charlysan/pico-ttl2dvi/docs/waveshare/idc_pinout.txt

DB-9 (male, front view)        IDC-10 (front view)

   1   2   3   4   5             1   3   5   7   9
 \ o   o   o   o   o /         [ o   o   o   o   o ]
   \ o   o   o   o /           [ o   o   o   o   o ]
     6   7   8   9               2   4   6   8   10

 DB-9        IDC-10
-------------------
 pin 1  <->  pin 1
 pin 2  <->  pin 2
 pin 3  <->  pin 3
 pin 4  <->  pin 4
 pin 5  <->  pin 5
 pin 6  <->  pin 6
 pin 7  <->  pin 7
 pin 8  <->  pin 8
 pin 9  <->  pin 9
 NC     <->  pin 10

 NC = Not Connected
