charlysan/pico-ttl2dvi/docs/waveshare/rp2350_pizero_waveshare_pinout.txt

              J5
 Function  Label    Pin | Pin  Label    Function
-------------------------+-------------------------
           3V3       1  |  2   VBUS
 SDA       GPIO2     3  |  4   VBUS
 SCL       GPIO3     5  |  6   GND
           GPIO14    7  |  8   GPIO4    TX
           GND       9  | 10   GPIO5    RX
           GPIO17   11  | 12   GPIO18
           GPIO27   13  | 14   GND
           GPIO22   15  | 16   GPIO23
           3V3      17  | 18   GPIO24
 SPI_MOSI  GPIO11   19  | 20   GND
 SPI_MISO  GPIO12   21  | 22   GPIO25
 SPI_SCLK  GPIO10   23  | 24   GPIO8    CE0
           GND      25  | 26   GPIO7    CE1
 ID_SDA    GPIO0    27  | 28   GPIO1    ID_SCL
           GPIO15   29  | 30   GND
           GPIO6    31  | 32   GPIO9
           GPIO13   33  | 34   GND
           GPIO19   35  | 36   GPIO16
           GPIO26   37  | 38   GPIO20
           GND      39  | 40   GPIO21
