charlysan/pico-ttl2dvi/hardware/tht/revA/ttl2dvi_tht.kicad_sch

## KiCad design hardware/tht/revA/ttl2dvi_tht.kicad_sch (2026-10-14)

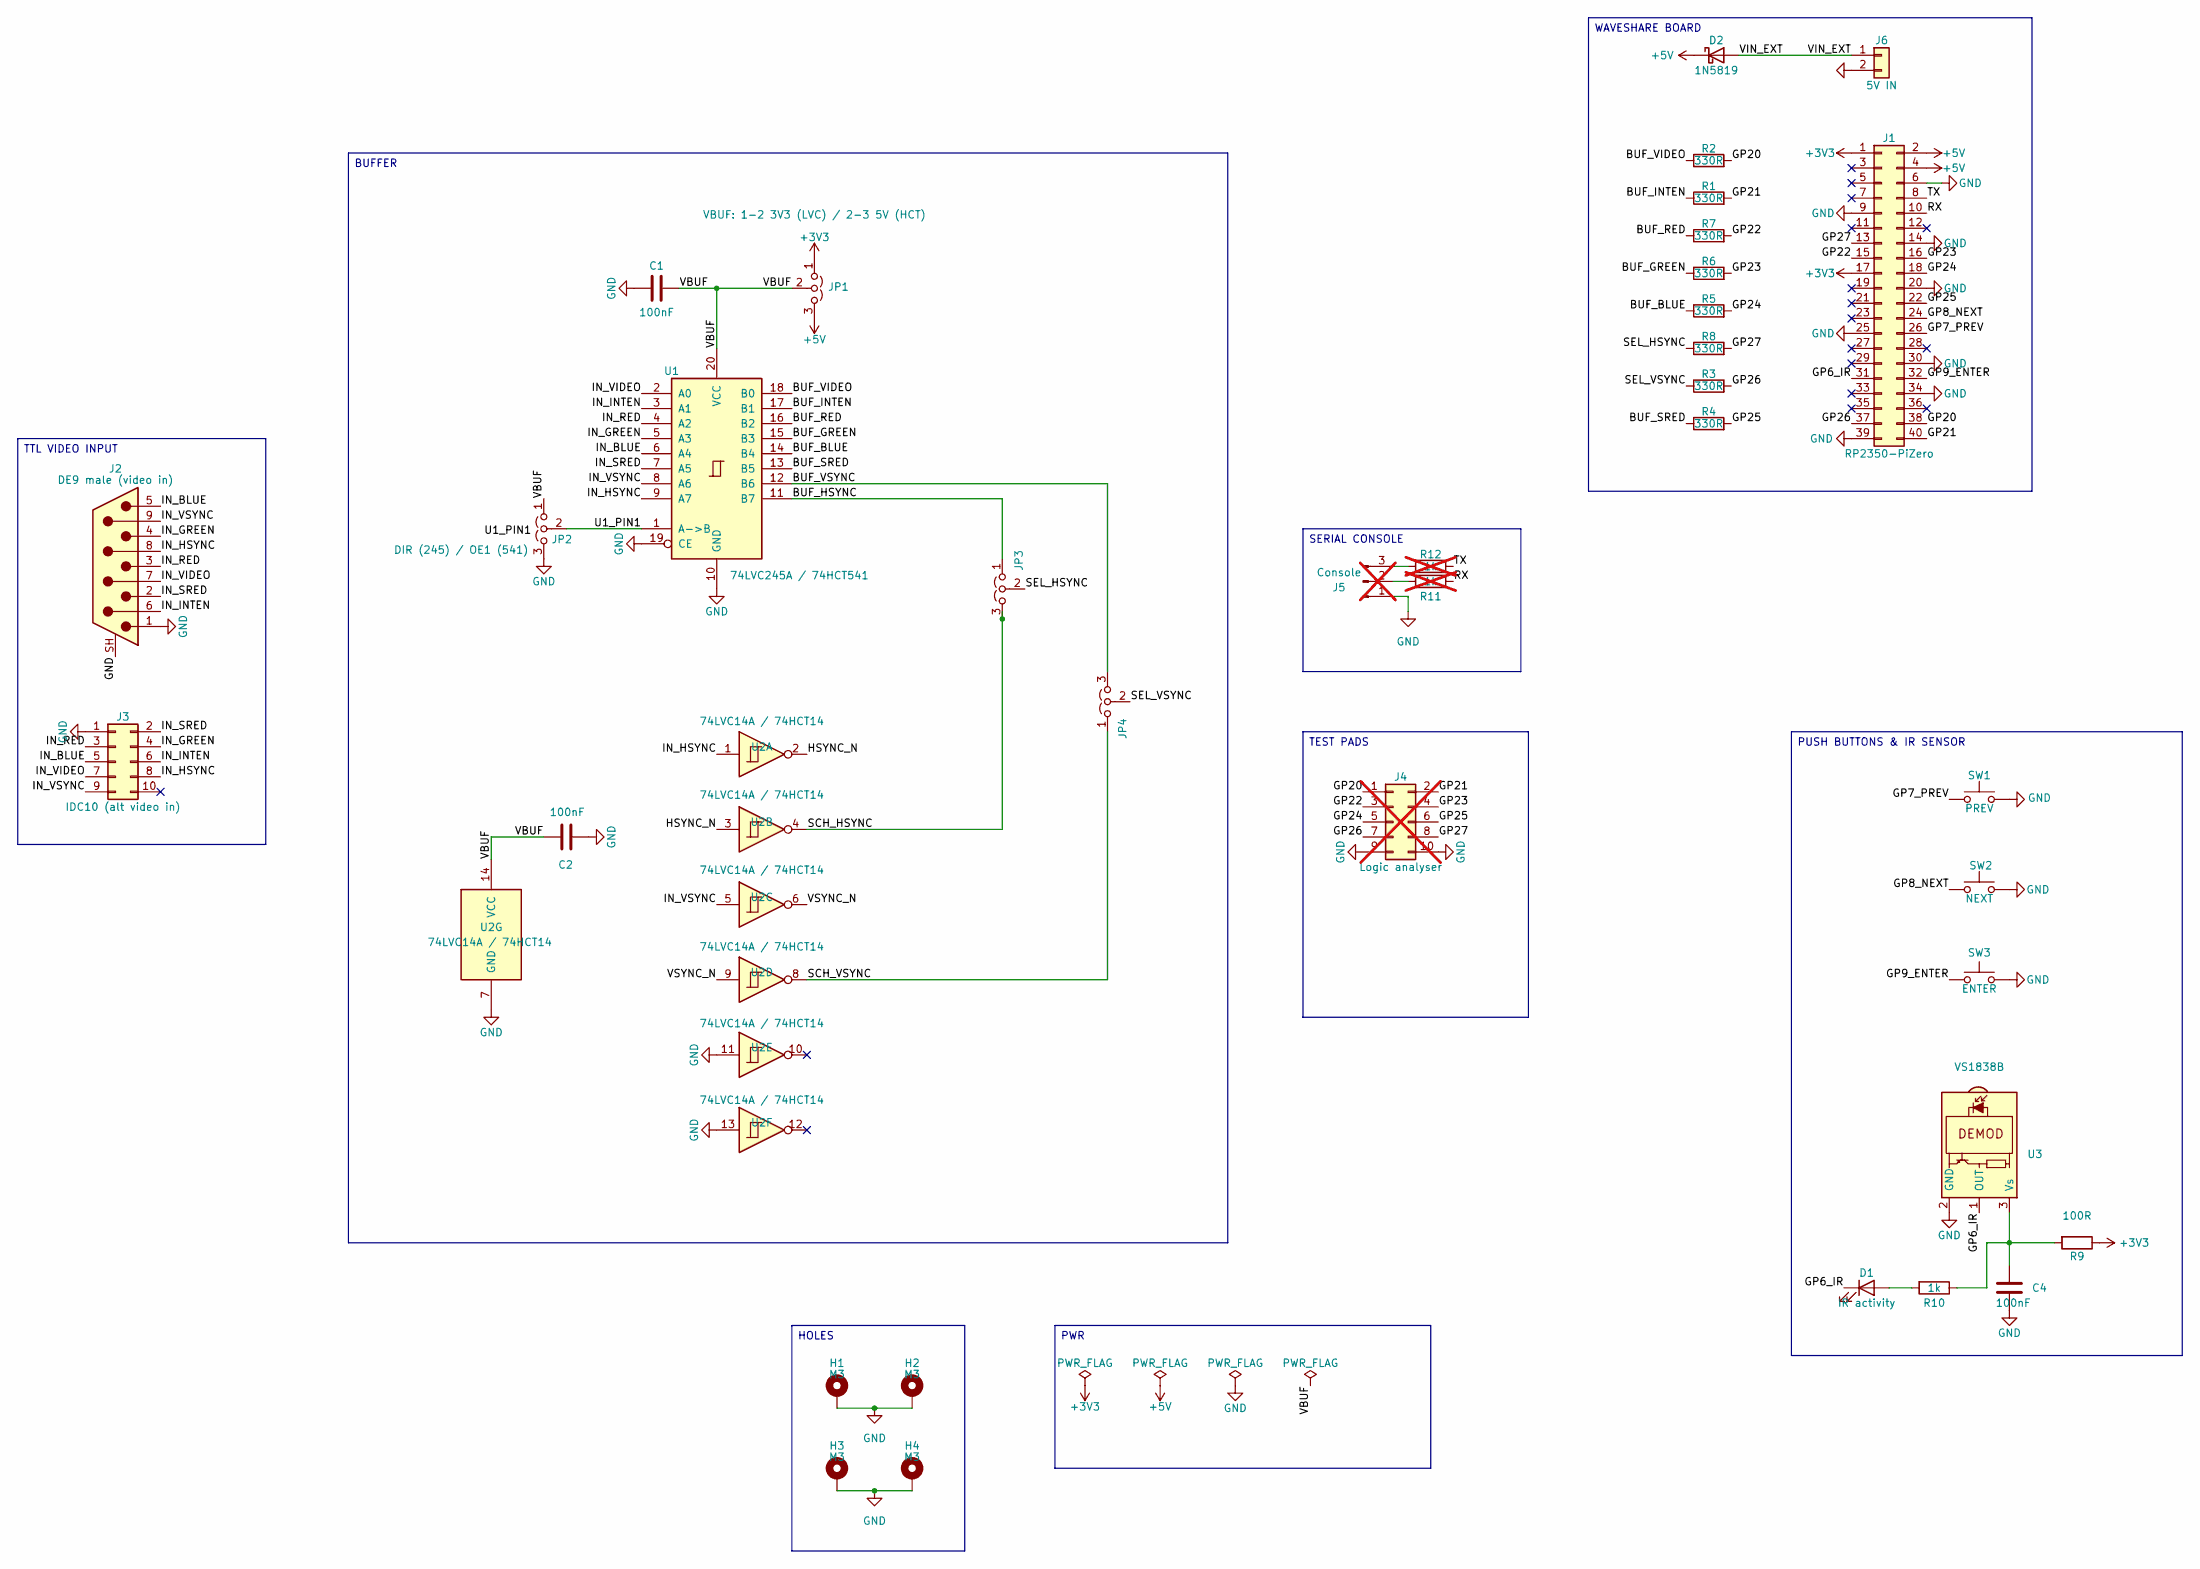
[picture p4: schematic ttl2dvi_tht.kicad_sch]

Parts:
C1, C2, C4: 100nF; C_Disc_D5.0mm_W2.5mm_P5.00mm
D1: IR activity; LED_D3.0mm
D2: 1N5819; D_DO-41_SOD81_P10.16mm_Horizontal
H1, H2, H3, H4: M3; MountingHole_3.2mm_M3_Pad_Via
J1: RP2350-PiZero; Raspberry_Pi_Zero_Socketed_THT_FaceDown_MountingHoles
J2: DE9 male (video in); DSUB-9_Pins_Horizontal_P2.77x2.84mm_EdgePinOffset7.70mm_Hou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
J3: IDC10 (alt video in); IDC-Header_2x05_P2.54mm_Vertical
J4: Logic analyser; PinHeader_2x05_P2.54mm_Vertical; not fitted
J5: Console; PinHeader_1x03_P2.54mm_Vertical; not fitted
J6: 5V IN; JST_XH_B2B-XH-A_1x02_P2.50mm_Vertical
JP1: VBUF: 1-2 3V3 (LVC) / 2-3 5V (HCT); PinHeader_1x03_P2.54mm_Vertical
JP2: DIR (245) / OE1 (541); PinHeader_1x03_P2.54mm_Vertical
JP3: HSYNC: 1-2 BUF / 2-3 SCH; PinHeader_1x03_P2.54mm_Vertical
JP4: VSYNC: 1-2 BUF / 2-3 SCH; PinHeader_1x03_P2.54mm_Vertical
R1, R2, R3, R4, R5, R6, R7, R8: 330R; R_Axial_DIN0207_L6.3mm_D2.5mm_P7.62mm_Horizontal
R9: 100R; R_Axial_DIN0207_L6.3mm_D2.5mm_P7.62mm_Horizontal
R10: 1k; R_Axial_DIN0207_L6.3mm_D2.5mm_P7.62mm_Horizontal
R11, R12: 1k; R_Axial_DIN0207_L6.3mm_D2.5mm_P7.62mm_Horizontal; not fitted
SW1: PREV; SW_PUSH_6mm
SW2: NEXT; SW_PUSH_6mm
SW3: ENTER; SW_PUSH_6mm
U1: 74LVC245A / 74HCT541; DIP-20_W7.62mm_Socket
U2: 74LVC14A / 74HCT14; DIP-14_W7.62mm_Socket
U3: VS1838B; Vishay_MOLD-3Pin

Connections:
+3V3: J1.1, J1.17, JP1.1 (A), R9.1
+5V: D2.1 (K), J1.2, J1.4, JP1.3 (B)
BUF_BLUE: R5.1, U1.14 (B4)
BUF_GREEN: R6.1, U1.15 (B3)
BUF_HSYNC: JP3.1 (A), U1.11 (B7)
BUF_INTEN: R1.1, U1.17 (B1)
BUF_RED: R7.1, U1.16 (B2)
BUF_SRED: R4.1, U1.13 (B5)
BUF_VIDEO: R2.1, U1.18 (B0)
BUF_VSYNC: JP4.3 (B), U1.12 (B6)
GND: C1.1, C2.2, C4.2, H1.1, H2.1, H3.1, H4.1, J1.6, J1.9, J1.14, J1.20, J1.25, J1.30, J1.34, J1.39, J2.1, J2.SH (PAD), J3.1, J4.9, J4.10, J5.1, J6.2, JP2.3 (B), SW1.2, SW2.2, SW3.2, U1.10 (GND), U1.19 (CE), U2.7 (GND), U2.11, U2.13, U3.2 (GND)
GP6_IR: D1.1 (K), J1.31, U3.1 (OUT)
GP7_PREV: J1.26, SW1.1
GP8_NEXT: J1.24, SW2.1
GP9_ENTER: J1.32, SW3.1
GP20: J1.38, J4.1, R2.2
GP21: J1.40, J4.2, R1.2
GP22: J1.15, J4.3, R7.2
GP23: J1.16, J4.4, R6.2
GP24: J1.18, J4.5, R5.2
GP25: J1.22, J4.6, R4.2
GP26: J1.37, J4.7, R3.2
GP27: J1.13, J4.8, R8.2
HSYNC_N: U2.2, U2.3
IN_BLUE: J2.5, J3.5, U1.6 (A4)
IN_GREEN: J2.4, J3.4, U1.5 (A3)
IN_HSYNC: J2.8, J3.8, U1.9 (A7), U2.1
IN_INTEN: J2.6, J3.6, U1.3 (A1)
IN_RED: J2.3, J3.3, U1.4 (A2)
IN_SRED: J2.2, J3.2, U1.7 (A5)
IN_VIDEO: J2.7, J3.7, U1.2 (A0)
IN_VSYNC: J2.9, J3.9, U1.8 (A6), U2.5
unnamed: C4.1, R9.2, R10.1, U3.3 (Vs)
unnamed: D1.2 (A), R10.2
unnamed: J5.2, R11.2
unnamed: J5.3, R12.2
RX: J1.10, R11.1
SCH_HSYNC: JP3.3 (B), U2.4
SCH_VSYNC: JP4.1 (A), U2.8
SEL_HSYNC: JP3.2 (C), R8.1
SEL_VSYNC: JP4.2 (C), R3.1
TX: J1.8, R12.1
U1_PIN1: JP2.2 (C), U1.1 (A->B)
VBUF: C1.2, C2.1, JP1.2 (C), JP2.1 (A), U1.20 (VCC), U2.14 (VCC)
VIN_EXT: D2.2 (A), J6.1
VSYNC_N: U2.6, U2.9

Notes on the sheet:
WAVESHARE BOARD
PUSH BUTTONS & IR SENSOR
TEST PADS
BUFFER
SERIAL CONSOLE
TTL VIDEO INPUT
HOLES
PWR
