charlysan/pico-ttl2dvi/apps/ttl2dvi/remote.h

#ifndef TTL2DVI_REMOTE_H
#define TTL2DVI_REMOTE_H

#include "pico/types.h"     // uint

// Loads the key map from flash and starts the decoder.
void remote_init(void);

// Drains the IR decoder. Mapped @up/@down/@enter/@back come back as EV_*
// bits, as from buttons_poll(); other actions run as console commands.
uint remote_poll(void);

// Writes text as the key map (same format as tools/irlearn.py) and reboots.
// Returns only if it doesn't fit the sector.
void remote_save_map(const char *text);

// ir on|off: print every received code. ir map: list the loaded map.
void cmd_ir(int argc, char **argv);

#endif
