charlysan/pico-ttl2dvi/(commit log)

2026-07-26 add capture PIO logic and python script to capture frame
2026-09-28 rename cga source - add frame counter
2026-09-28 add measure and auto source switching
2026-09-29 add slots
2026-09-29 update Readme - fix typo
    [main.c]
2026-10-03 implement buttons and single line menu
2026-10-08 add pcb design note
2026-10-08 add reset shortcuts and quickstart guide
    [buttons.c, buttons.h, commands.c, commands.h, main.c, osd.c, osd.h]
2026-10-12 Add disclaimer and adapter adapter board screenshot
2026-10-13 Add kicad files for tht rev x1 (experimental)
2026-10-13 add pcb screenshots
